el-nikitos/ITC-1/ITC-1-EXT-CONNECTION/Снимок экрана-1.png

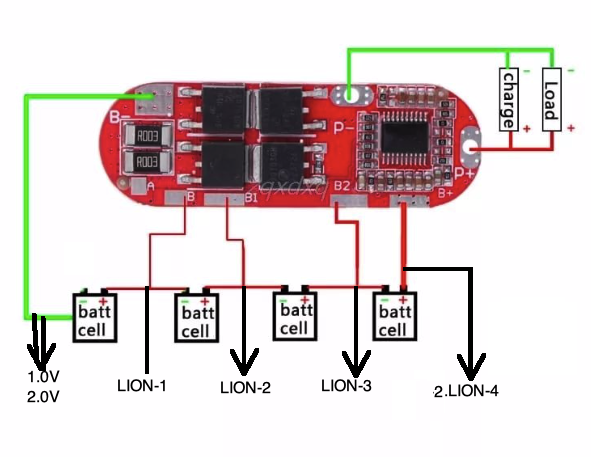
ITC-1-EXT-CONNECTION/Снимок экрана-1.png
