el-nikitos/ITC-1/ITC-1-EXT-CONNECTION/Снимок экрана-2.png

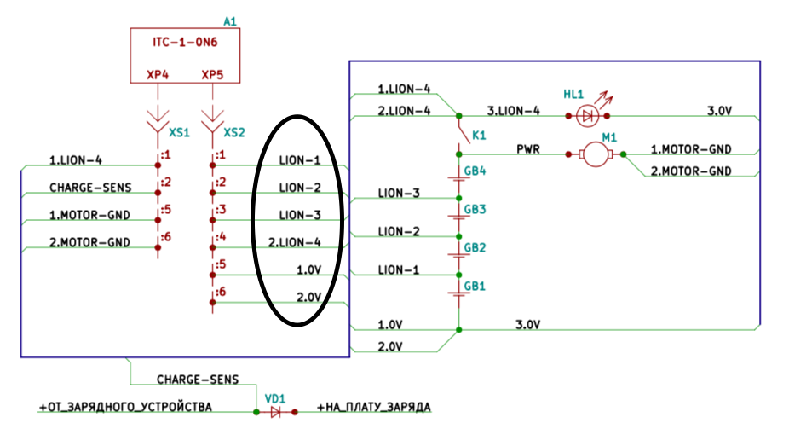
ITC-1-EXT-CONNECTION/Снимок экрана-2.png
