el-nikitos/ITC-1/ITC-1/PNG/ITC-1-B.png

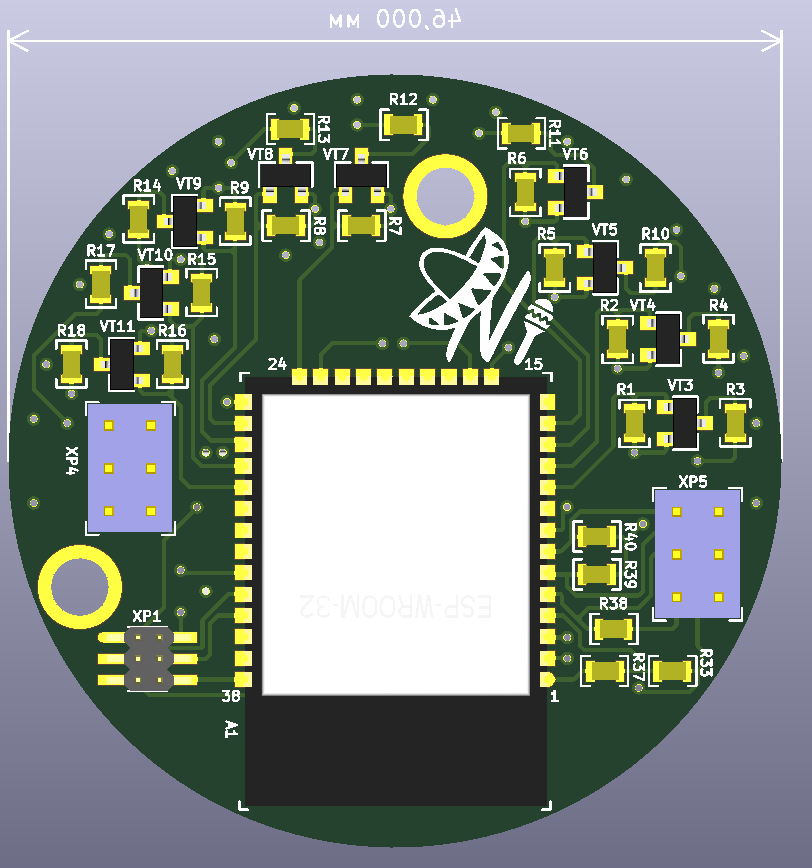
ITC-1/PNG/ITC-1-B.png
