el-nikitos/ITC-1/ITC-1/PNG/ITC-1-F.png

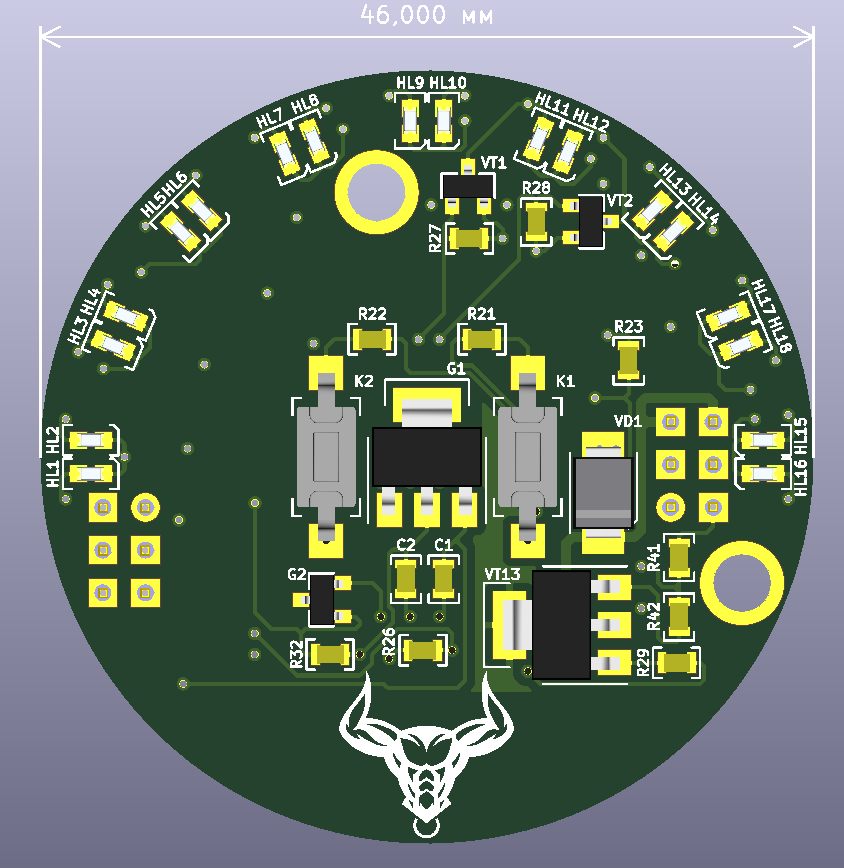
ITC-1/PNG/ITC-1-F.png
