el-nikitos/ITC-1/ITC-1/PDF/ITC-1.pdf

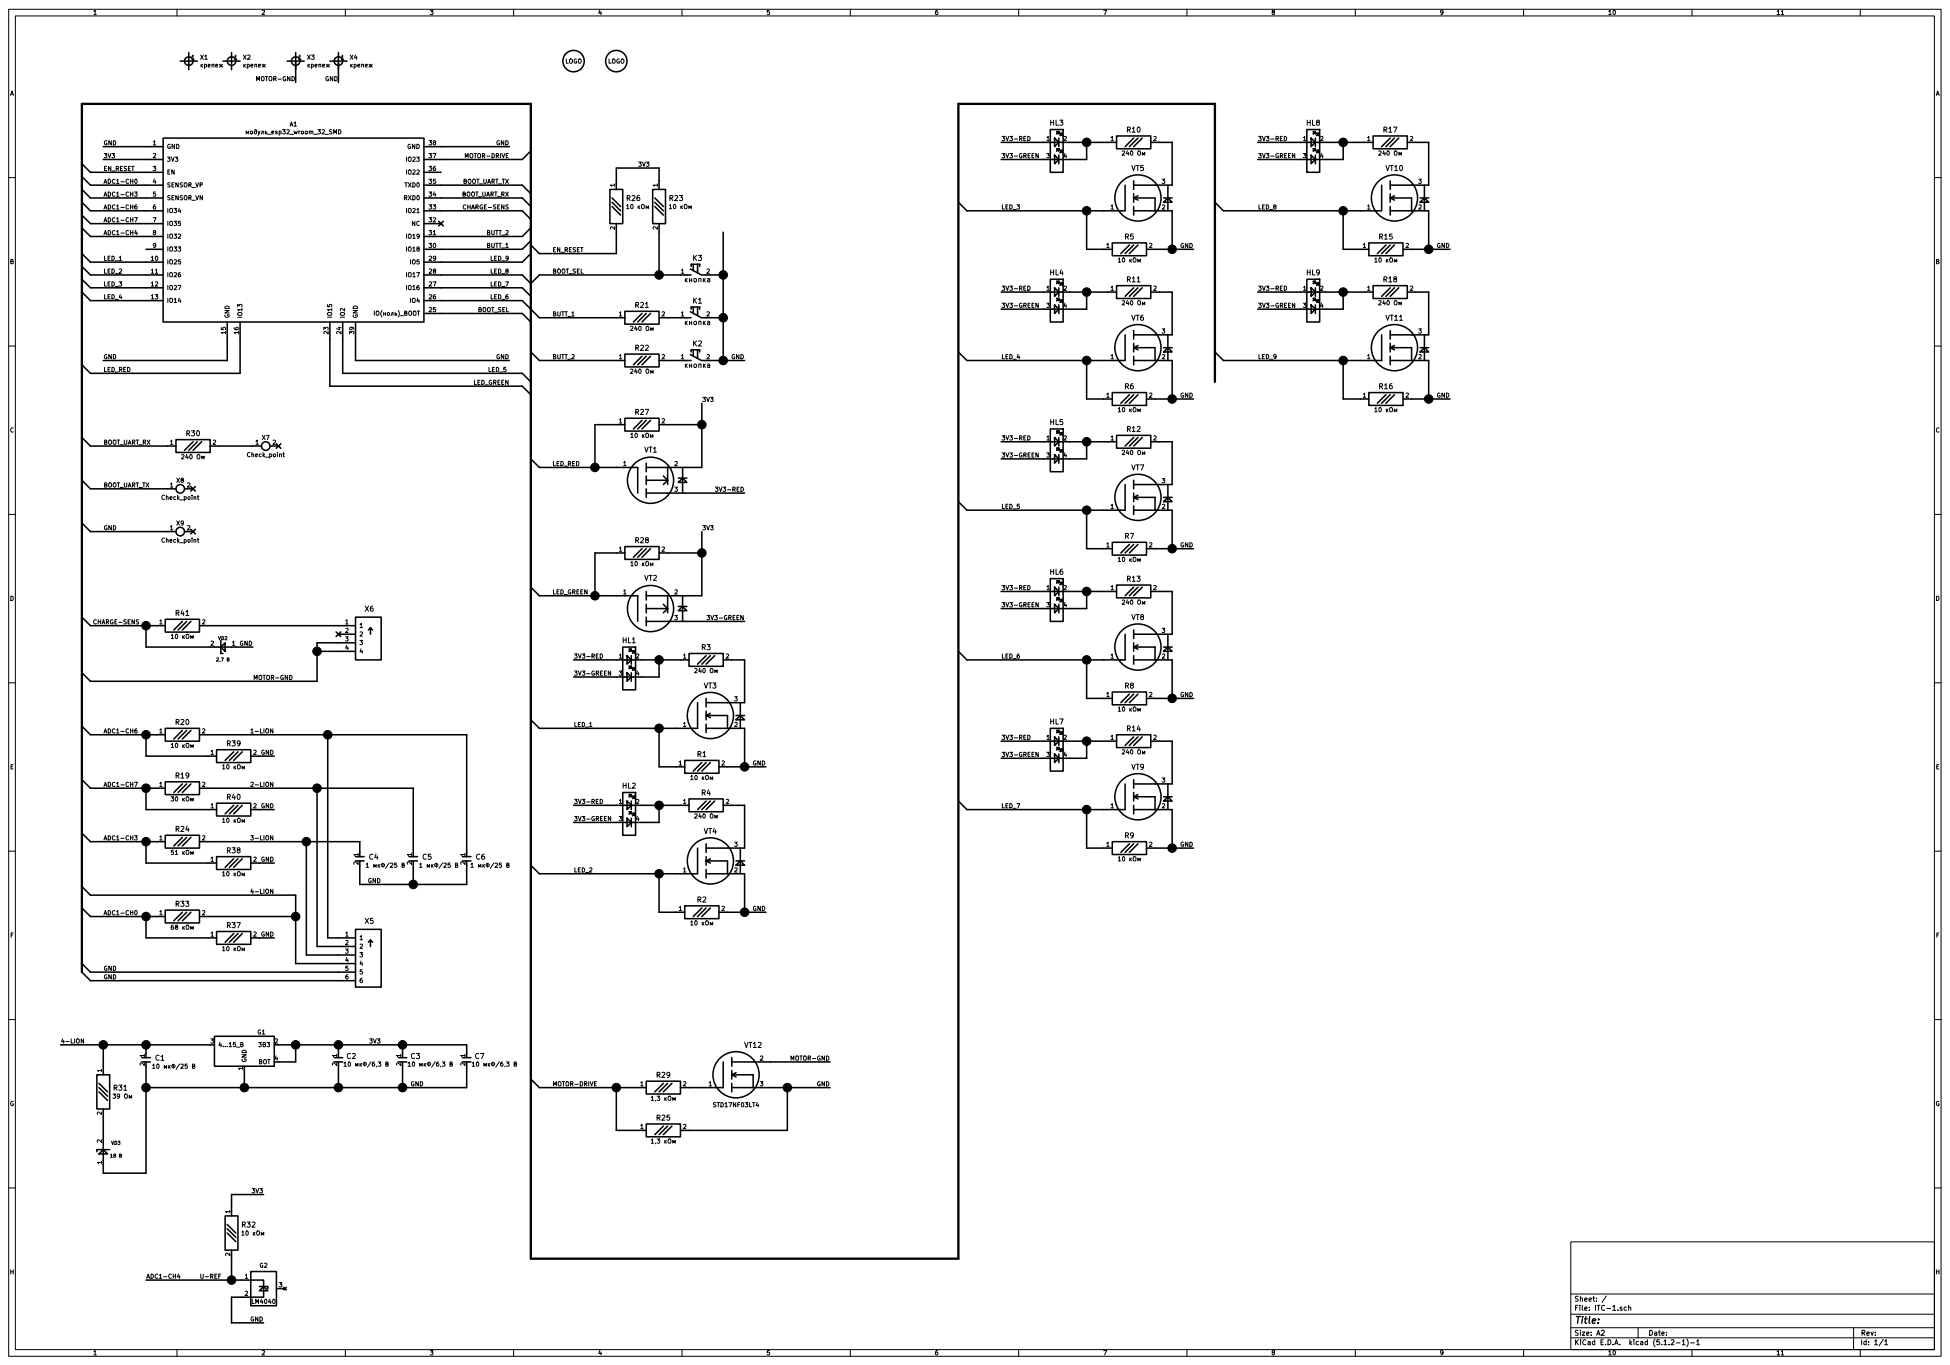
[picture p5: page 1]

Id: 1/1 Title: File: ITC-1.sch Sheet: /
