el-nikitos/ITC-1/ITC-1/ITC-1.kicad_pcb

## KiCad design ITC-1/ITC-1.kicad_pcb (2021-10-17)

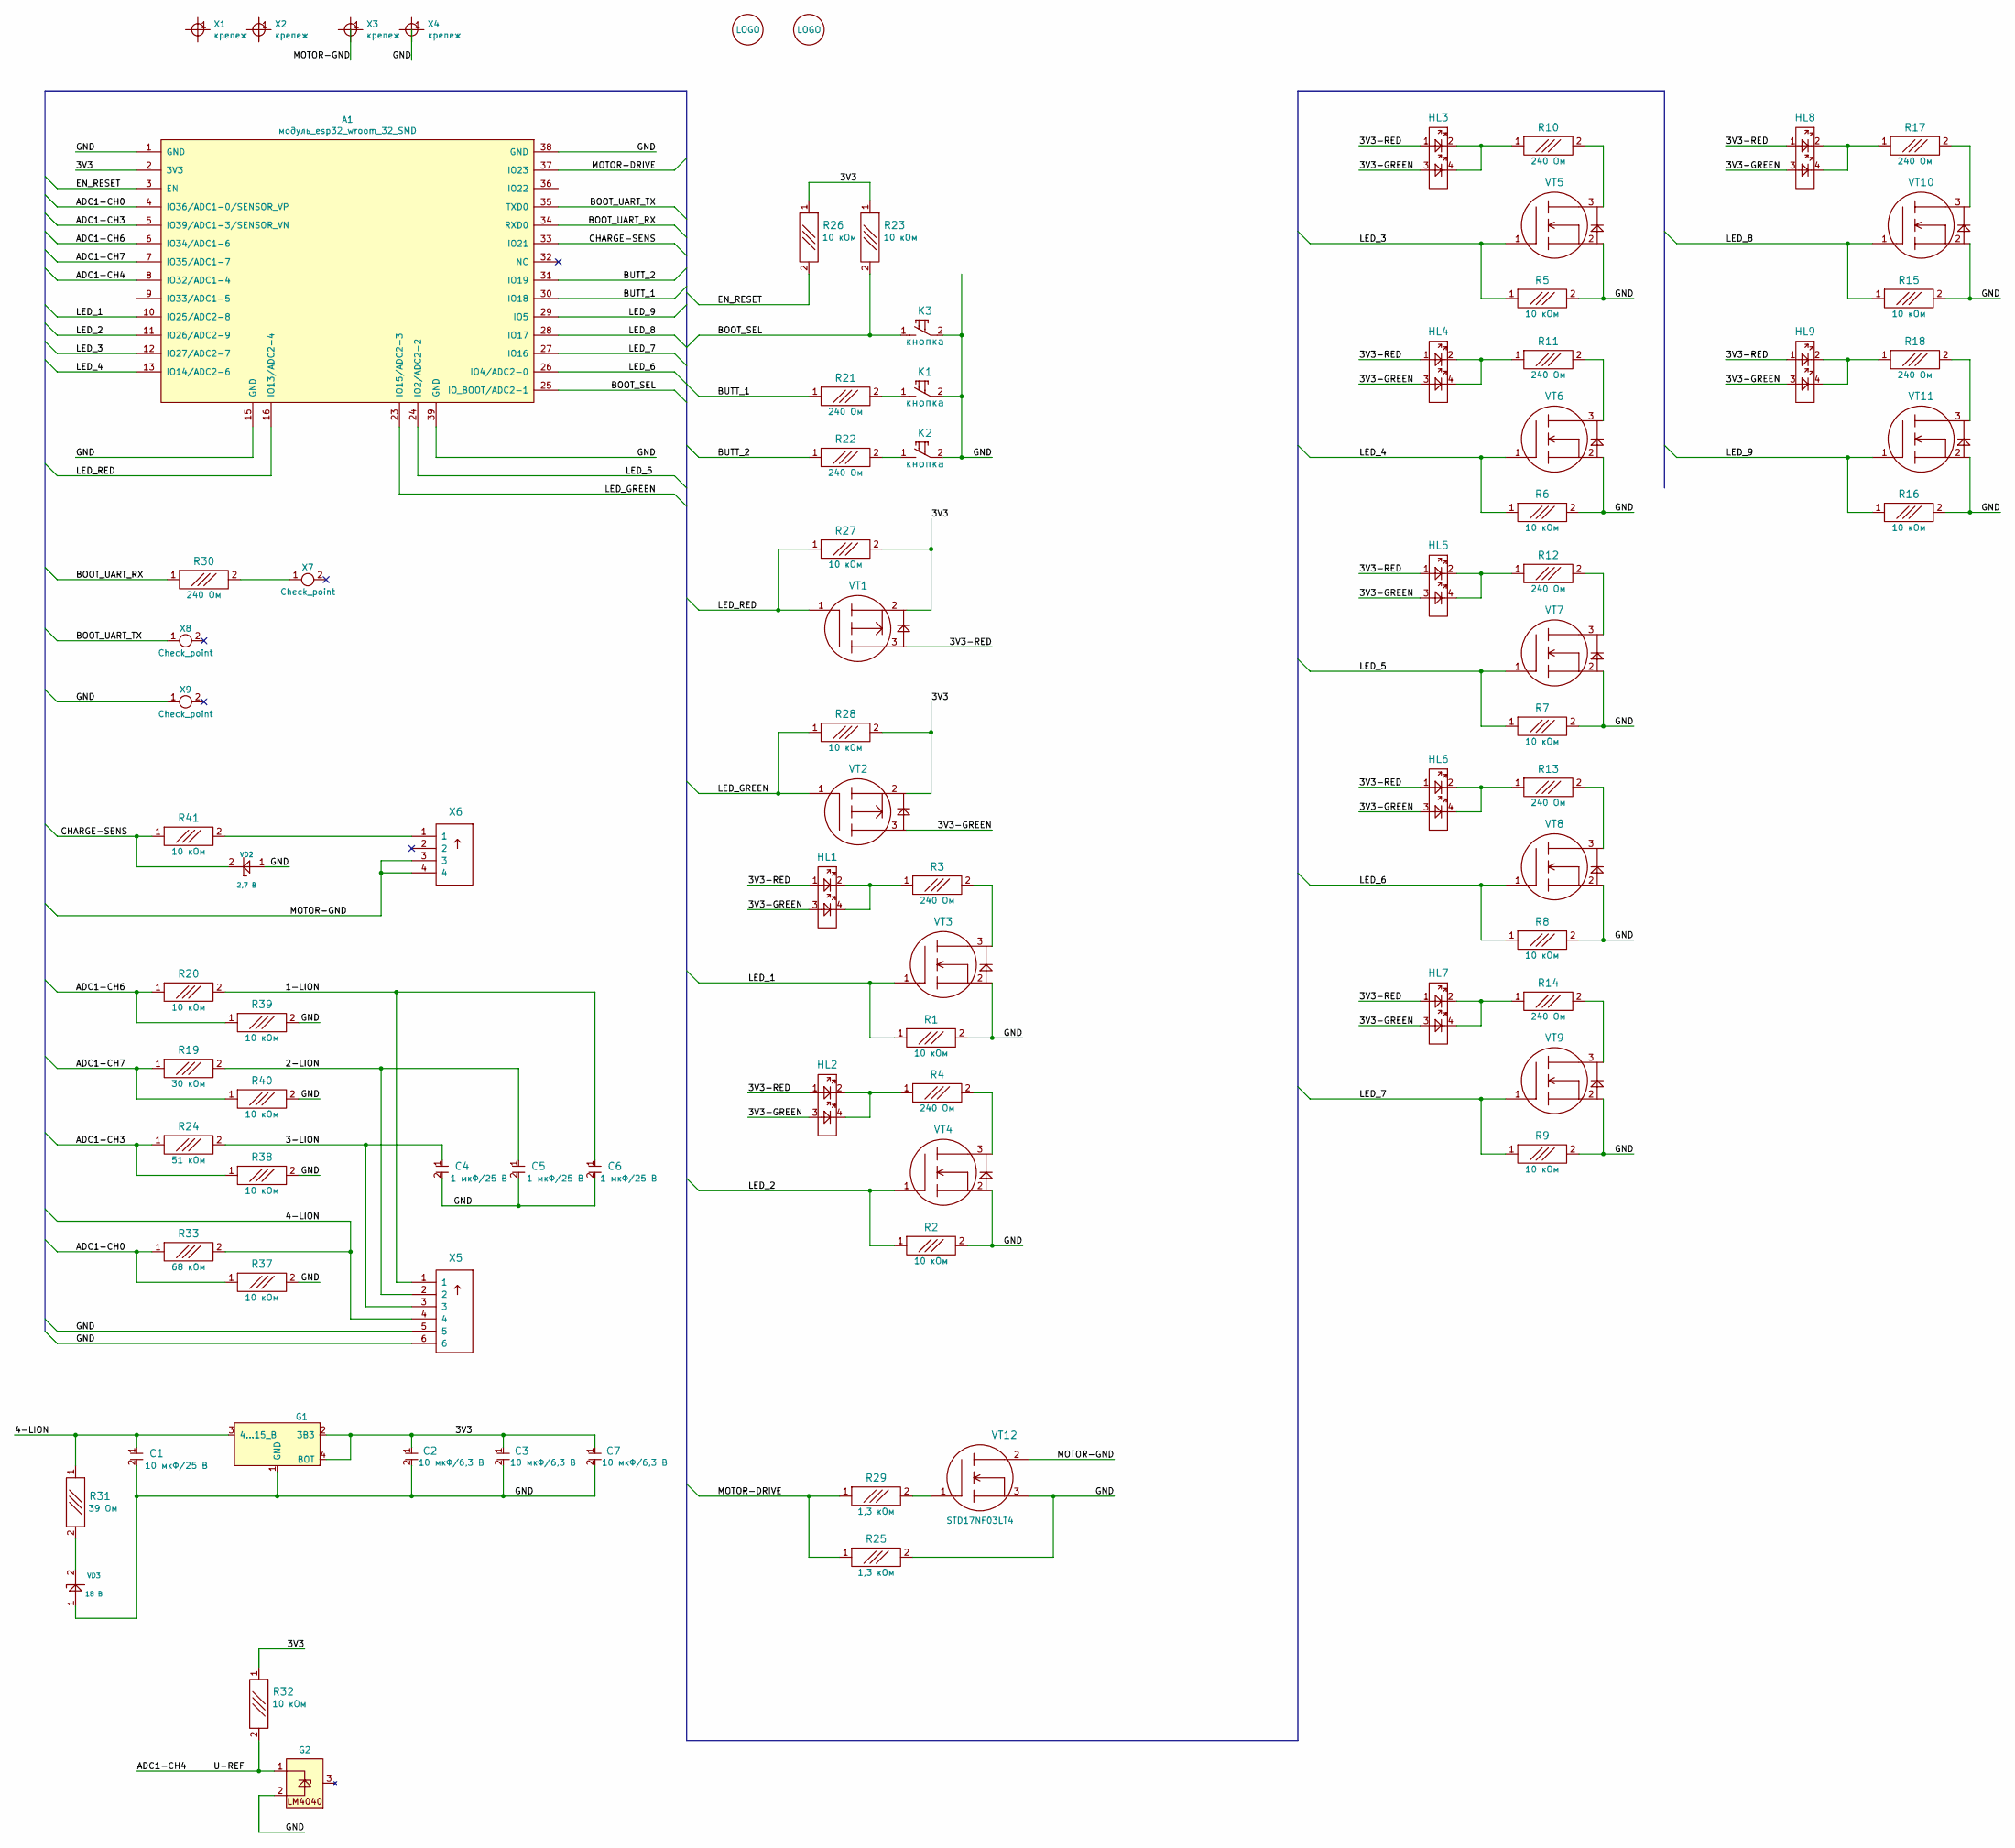
[picture p6: schematic ITC-1.sch]

Parts:
A1: модуль_esp32_wroom_32_SMD; ESP32_WROOM32_pnp_noSD
C1: Конденсатор_керамический; Конденсатор_SMD_IEC_0805
C2, C3, C4, C5, C6, C7: Конденсатор_керамический; Конденсатор_SMD_0603_pnp
D1: LOGO; ni_10x10
D2: LOGO; VLAD_10x10
G1: стабилизатор_нерегулируемый_LM1117S33; Транзистор_NPN_SOT223_pnp
G2: ИОП_LM4040BIM3-2.5_NOPB; Корпус_КТ-46
HL1, HL2, HL3, HL4, HL5, HL6, HL7, HL8, HL9: Светодиод_сдвоенный_KPB-3025SURKCGKC; Светодиод_SMD_m3025
K1, K2, K3: кнопка; Кнопка_FSMSM
R1, R2, R3, R4, R5, R6, R7, R8, R9, R10, R11, R12, R13, R14, R15, R16, R17, R18, R19, R20, R21, R22, R23, R24, R25, R26, R27, R28, R29, R30, R31, R32, R33, R37, R38, R39, R40, R41: Резистор_0,065Вт; Резистор_SMD_0603_0,065_Вт_pnp
VD2, VD3: Стабилитрон_1N5352BRLG_вертикальный; SOD-80
VT1, VT2: Транзистор_полевой_P-канал(IRLML2246TRPBF); Транзистор_IRLML6344TR_SOT-23
VT3, VT4, VT5, VT6, VT7, VT8, VT9, VT10, VT11: Транзистор_полевой_N-IRLML6344TR; Транзистор_IRLML6344TR_SOT-23
VT12: Транзистор_полевой_N-канал; Транзистор_N-канал_dpak_DS
X1, X2: крепеж; Отверстие_М3
X3, X4: крепеж; ОтверстиеD1.2
X5: Вилка_PLS6; Вилка_PLD6_вертикальная
X6: Вилка_PLS4; Вилка_PLD4_вертикальная
X7, X8, X9: Check_point; Пробник

Connections:
/1-LION: C6.1, R20.2, X5.1
/2-LION: C5.1, R19.2, X5.2
/3-LION: C4.1, R24.2, X5.3
/3V3: A1.2 (3V3), C2.1, C3.1, C7.1, G1.2 (3В3), G1.4 (BOT), R23.1, R26.1, R27.2, R28.2, R32.1, VT1.2, VT2.2
/3V3-GREEN: HL1.3, HL2.3, HL3.3, HL4.3, HL5.3, HL6.3, HL7.3, HL8.3, HL9.3, VT2.3
/3V3-RED: HL1.1, HL2.1, HL3.1, HL4.1, HL5.1, HL6.1, HL7.1, HL8.1, HL9.1, VT1.3
/4-LION: C1.1, G1.3 (4...15_В), R31.1, R33.2, X5.4
/ADC1-CH0: A1.4 (IO36/ADC1-0/SENSOR_VP), R33.1, R37.1
/ADC1-CH3: A1.5 (IO39/ADC1-3/SENSOR_VN), R24.1, R38.1
/ADC1-CH4: A1.8 (IO32/ADC1-4), G2.1, R32.2
/ADC1-CH6: A1.6 (IO34/ADC1-6), R20.1, R39.1
/ADC1-CH7: A1.7 (IO35/ADC1-7), R19.1, R40.1
/BOOT_SEL: A1.25 (IO_BOOT/ADC2-1), K3.1, R23.2
/BOOT_UART_RX: A1.34 (RXD0), R30.1
/BOOT_UART_TX: A1.35 (TXD0), X8.1
/BUTT_1: A1.30 (IO18), R21.1
/BUTT_2: A1.31 (IO19), R22.1
/CHARGE-SENS: A1.33 (IO21), R41.1, VD2.2
/EN_RESET: A1.3 (EN), R26.2
/GND: A1.1 (GND), A1.15 (GND), A1.38 (GND), A1.39 (GND), C1.2, C2.2, C3.2, C4.2, C5.2, C6.2, C7.2, G1.1 (GND), G2.2, K1.2, K2.2, K3.2, R1.2, R2.2, R5.2, R6.2, R7.2, R8.2, R9.2, R15.2, R16.2, R25.2, R37.2, R38.2, R39.2, R40.2, VD2.1, VD3.1, VT3.2, VT4.2, VT5.2, VT6.2, VT7.2, VT8.2, VT9.2, VT10.2, VT11.2, VT12.3, X4.1, X5.5, X5.6, X9.1
/LED_1: A1.10 (IO25/ADC2-8), R1.1, VT3.1
/LED_2: A1.11 (IO26/ADC2-9), R2.1, VT4.1
/LED_3: A1.12 (IO27/ADC2-7), R5.1, VT5.1
/LED_4: A1.13 (IO14/ADC2-6), R6.1, VT6.1
/LED_5: A1.24 (IO2/ADC2-2), R7.1, VT7.1
/LED_6: A1.26 (IO4/ADC2-0), R8.1, VT8.1
/LED_7: A1.27 (IO16), R9.1, VT9.1
/LED_8: A1.28 (IO17), R15.1, VT10.1
/LED_9: A1.29 (IO5), R16.1, VT11.1
/LED_GREEN: A1.23 (IO15/ADC2-3), R28.1, VT2.1
/LED_RED: A1.16 (IO13/ADC2-4), R27.1, VT1.1
/MOTOR-DRIVE: A1.37 (IO23), R25.1, R29.1
/MOTOR-GND: VT12.2, X3.1, X6.3, X6.4
unnamed: HL1.2, HL1.4, R3.1
unnamed: HL2.2, HL2.4, R4.1
unnamed: HL3.2, HL3.4, R10.1
unnamed: HL4.2, HL4.4, R11.1
unnamed: HL5.2, HL5.4, R12.1
unnamed: HL6.2, HL6.4, R13.1
unnamed: HL7.2, HL7.4, R14.1
unnamed: HL8.2, HL8.4, R17.1
unnamed: HL9.2, HL9.4, R18.1
unnamed: K1.1, R21.2
unnamed: K2.1, R22.2
unnamed: R3.2, VT3.3
unnamed: R4.2, VT4.3
unnamed: R10.2, VT5.3
unnamed: R11.2, VT6.3
unnamed: R12.2, VT7.3
unnamed: R13.2, VT8.3
unnamed: R14.2, VT9.3
unnamed: R17.2, VT10.3
unnamed: R18.2, VT11.3
unnamed: R29.2, VT12.1
unnamed: R30.2, X7.1
unnamed: R31.2, VD3.2
unnamed: R41.2, X6.1

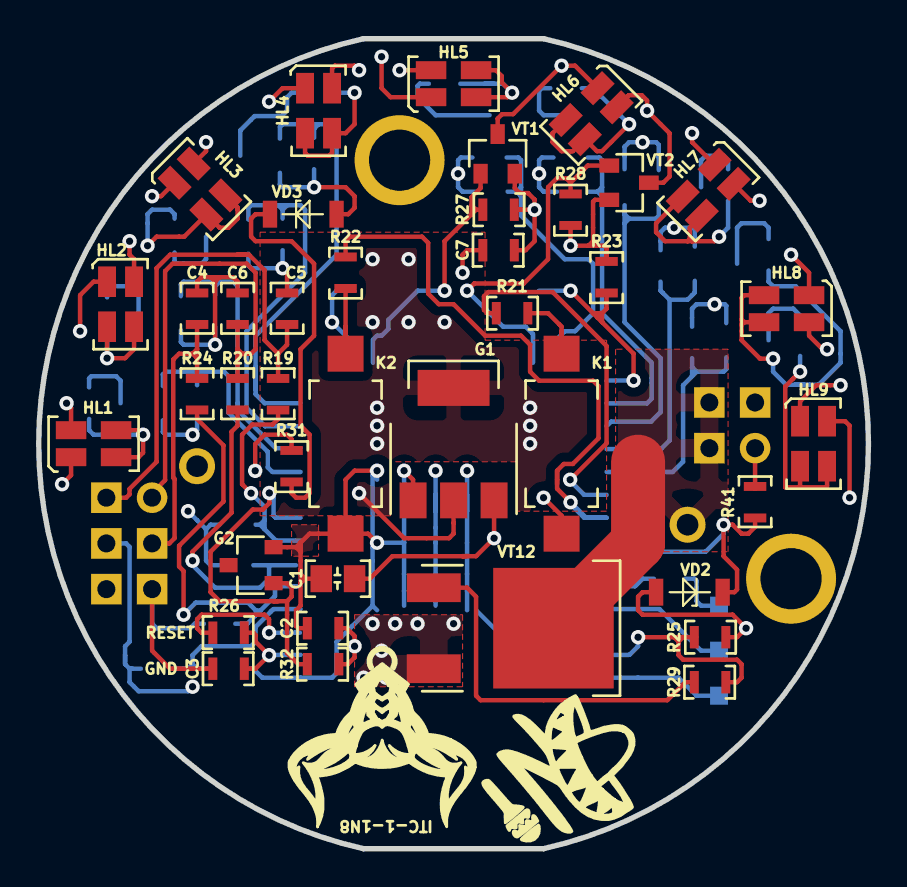
[picture p7: board ITC-1.kicad_pcb from above]

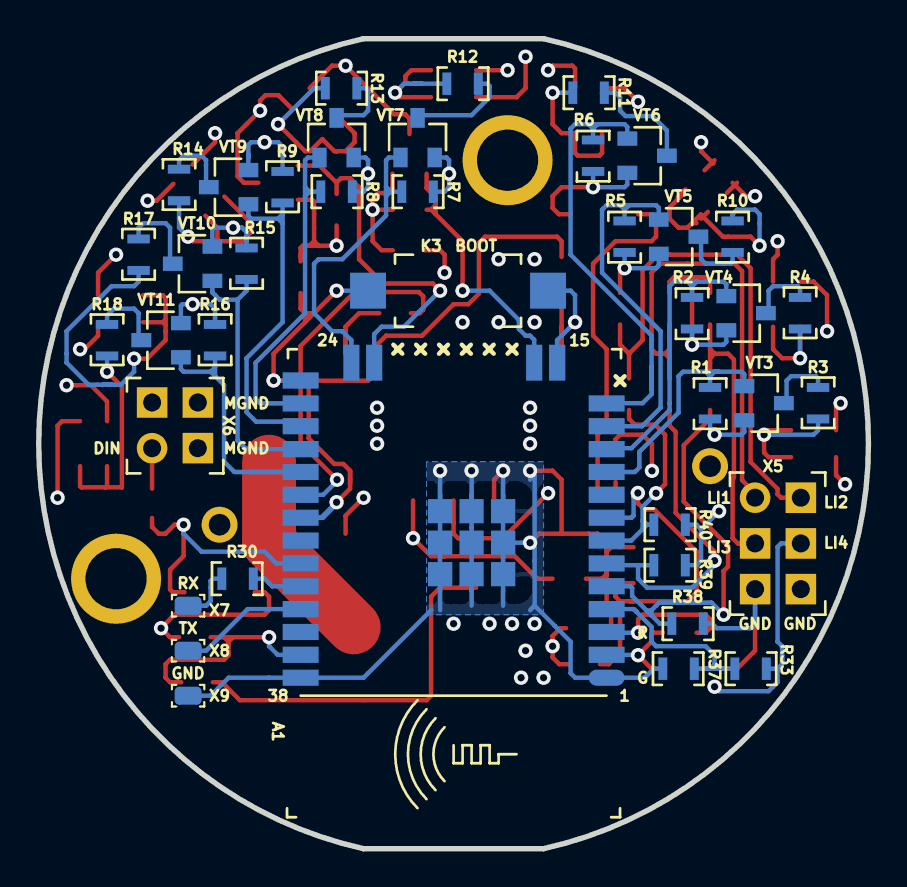
[picture p8: board ITC-1.kicad_pcb from below]

Board: 4 copper layers, 46.1 x 45.0 mm, 85 parts (40 on the bottom side), 57 nets.
