el-nikitos/ITC-1/(commit log)

2021-05-10 определено расположение основных элементов и габарит
    [ITC-1.kicad_pcb, ITC-1.sch]
2021-05-16 расположено управление светодиодами
    [ITC-1.kicad_pcb, ITC-1.sch]
2021-05-23 заменены разъемы, исключены ОУ, определена распиновка и упр. транзистор
    [ITC-1.kicad_pcb, ITC-1.sch]
2021-05-24 определено подключение аналоговых входов
    [ITC-1.kicad_pcb]
2021-05-25 упрощена схема подтяжек, раскинут разъем программирования
    [ITC-1.kicad_pcb, ITC-1.sch]
2021-05-29 раскинуты все разъемы, требуется подключить LED и поставить лого
    [ITC-1.kicad_pcb, ITC-1.sch]
2021-05-29 готова трассировка, требуется контрольная проверка
    [ITC-1.kicad_pcb, ITC-1.sch]
2021-05-30 добавлено отверстие для бондажа, требуется заменить светодиоды
    [ITC-1.kicad_pcb, ITC-1.sch]
2021-06-02 заменены светодиоды на сдвоенные
    [ITC-1.kicad_pcb, ITC-1.sch]
2021-06-03 закончена трассировка, сформированы герберы
    [ITC-1-B_Cu.gbr, ITC-1-B_Mask.gbr, ITC-1-B_SilkS.gbr, ITC-1-Edge_Cuts.gbr, ITC-1-F_Cu.gbr, ITC-1-F_Mask.gbr, ITC-1-F_SilkS.gbr, ITC-1-In1_Cu-GND.gbr]
2021-06-04 исправлено заземление транзистора, подготовлены файлы производства
    [ITC-1-B_Cu.gbr, ITC-1-B_Mask.gbr, ITC-1-B_SilkS.gbr, ITC-1-Edge_Cuts.gbr, ITC-1-F_Cu.gbr, ITC-1-F_Mask.gbr, ITC-1-F_SilkS.gbr, ITC-1-In1_Cu-GND.gbr]
2021-06-21 определены номиналы делителей, добавлены ссылки на чип и дип
    [ITC-1.sch]
2021-06-27 проект для схемы внешних подключений
    [ITC-1-EXT-CONNECTION.kicad_pcb, ITC-1-EXT-CONNECTION.sch]
2021-06-27 обновлена PDF, добавлены элементы платы на схеме внешних подключений
2021-06-27 обновлена верхняя схема
    [ITC-1-EXT-CONNECTION.dxf]
2021-06-27 подготовлена схема внешних подключений
    [ITC-1-EXT-CONNECTION.sch]
2021-08-11 arduino test: оцифровка, кнопки, светодиоды, шим - не систематизировано
2021-08-15 arduino: задержка запуска и выключение по таймауту
    [ITC-1-EXT-CONNECTION.sch]
2021-08-15 PCB: транзистор N-канал, утолщены дорожки, кнопка BOOT, заменен прог.
    [ITC-1.kicad_pcb, ITC-1.sch]
2021-08-17 ITC-1-1 исправлен проект
    добавлены стабилизаторы на DIN и LI4, усилены дорожки, фаски с двух сторон
    [ITC-1.kicad_pcb, ITC-1.sch]
2021-08-17 на esp32 убраны запрещенные площадки, сформированы gerber-файлы
    [ITC-1-B_Cu.gbr, ITC-1-B_Mask.gbr, ITC-1-B_SilkS.gbr, ITC-1-Edge_Cuts.gbr, ITC-1-F_Cu.gbr, ITC-1-F_Mask.gbr, ITC-1-F_SilkS.gbr, ITC-1-In1_Cu-GND.gbr]
2021-08-22 обновлена номенклатура для заказа ПКИ
    [ITC-1.sch]
2021-08-30 изменена индикация выбора скорости, добавлен перевод напряжения в заряд
2021-09-02 дополнительная индикация при низком заряде
2021-10-08 время работы движка - 60 сек, ШИМ - 150 Гц, при заряде led всегда мигают
2021-10-08 ШИМ 200 Гц, при заряде поочередно мигает текущее деление и следующее
2021-10-17 обновлены УГО ESP и список цепей
    [ITC-1.kicad_pcb, ITC-1.sch]
2021-10-24 WiFi AP + сервер и подсчет подключенных клиентов
2021-10-27 парсер приема по wifi.client; своё условие при наличии подсоединения
2021-10-28 реализовано включение/выключение по посылке start/stop
2021-12-19 добавлены команды speed++ и speed--
2022-01-23 обновлено УГО для внешнего подключения
    [ITC-1-EXT-CONNECTION.dxf, ITC-1-EXT-CONNECTION.sch]
2022-03-21 переведена работа с коллекторного движка на синхронный
2022-04-21 изменены частотные характеристики
